UCI-Rocket-Project/rocket2-loadcell2.0-hardware/rocket2-load-cell.step

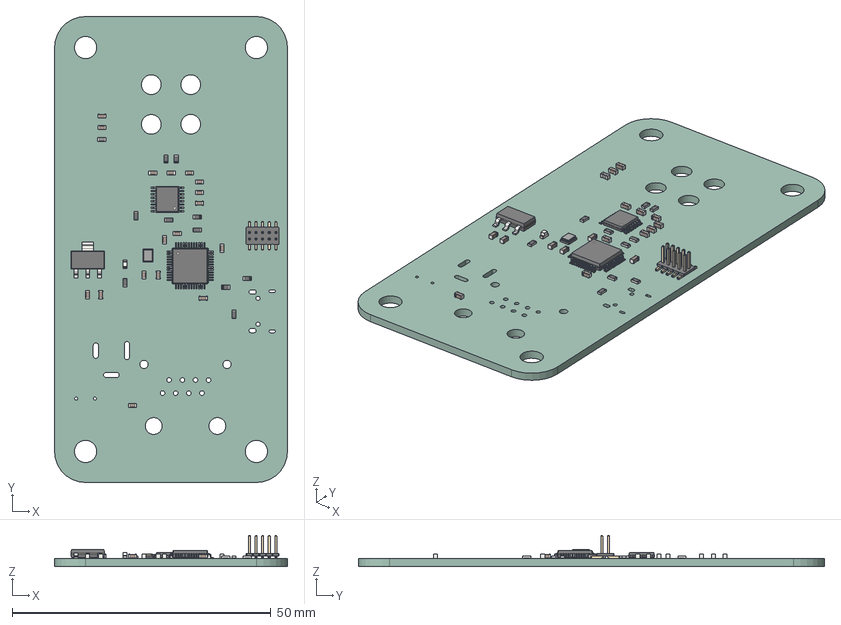
[picture p2: CAD file, 2025-10-12]
rocket2-load-cell.step
45.0 x 90.0 x 6.00 mm
LQFP-48_7x7mm_P0.5mm
C_0603_1608Metric x 17
R_0603_1608Metric x 10
LED_0603_1608Metric
L_0603_1608Metric
TSSOP-16_4.4x5mm_P0.65mm
Crystal_SMD_2520-4Pin_2.5x2.0mm
SOT-223
PinHeader_2x05_P1.27mm_Vertical_SMD
rocket2-load-cell_PCB
