UCI-Rocket-Project/rocket2-loadcell2.0-hardware/rocket2-load-cell.kicad_pcb

## KiCad design rocket2-load-cell.kicad_pcb (2025-11-19)

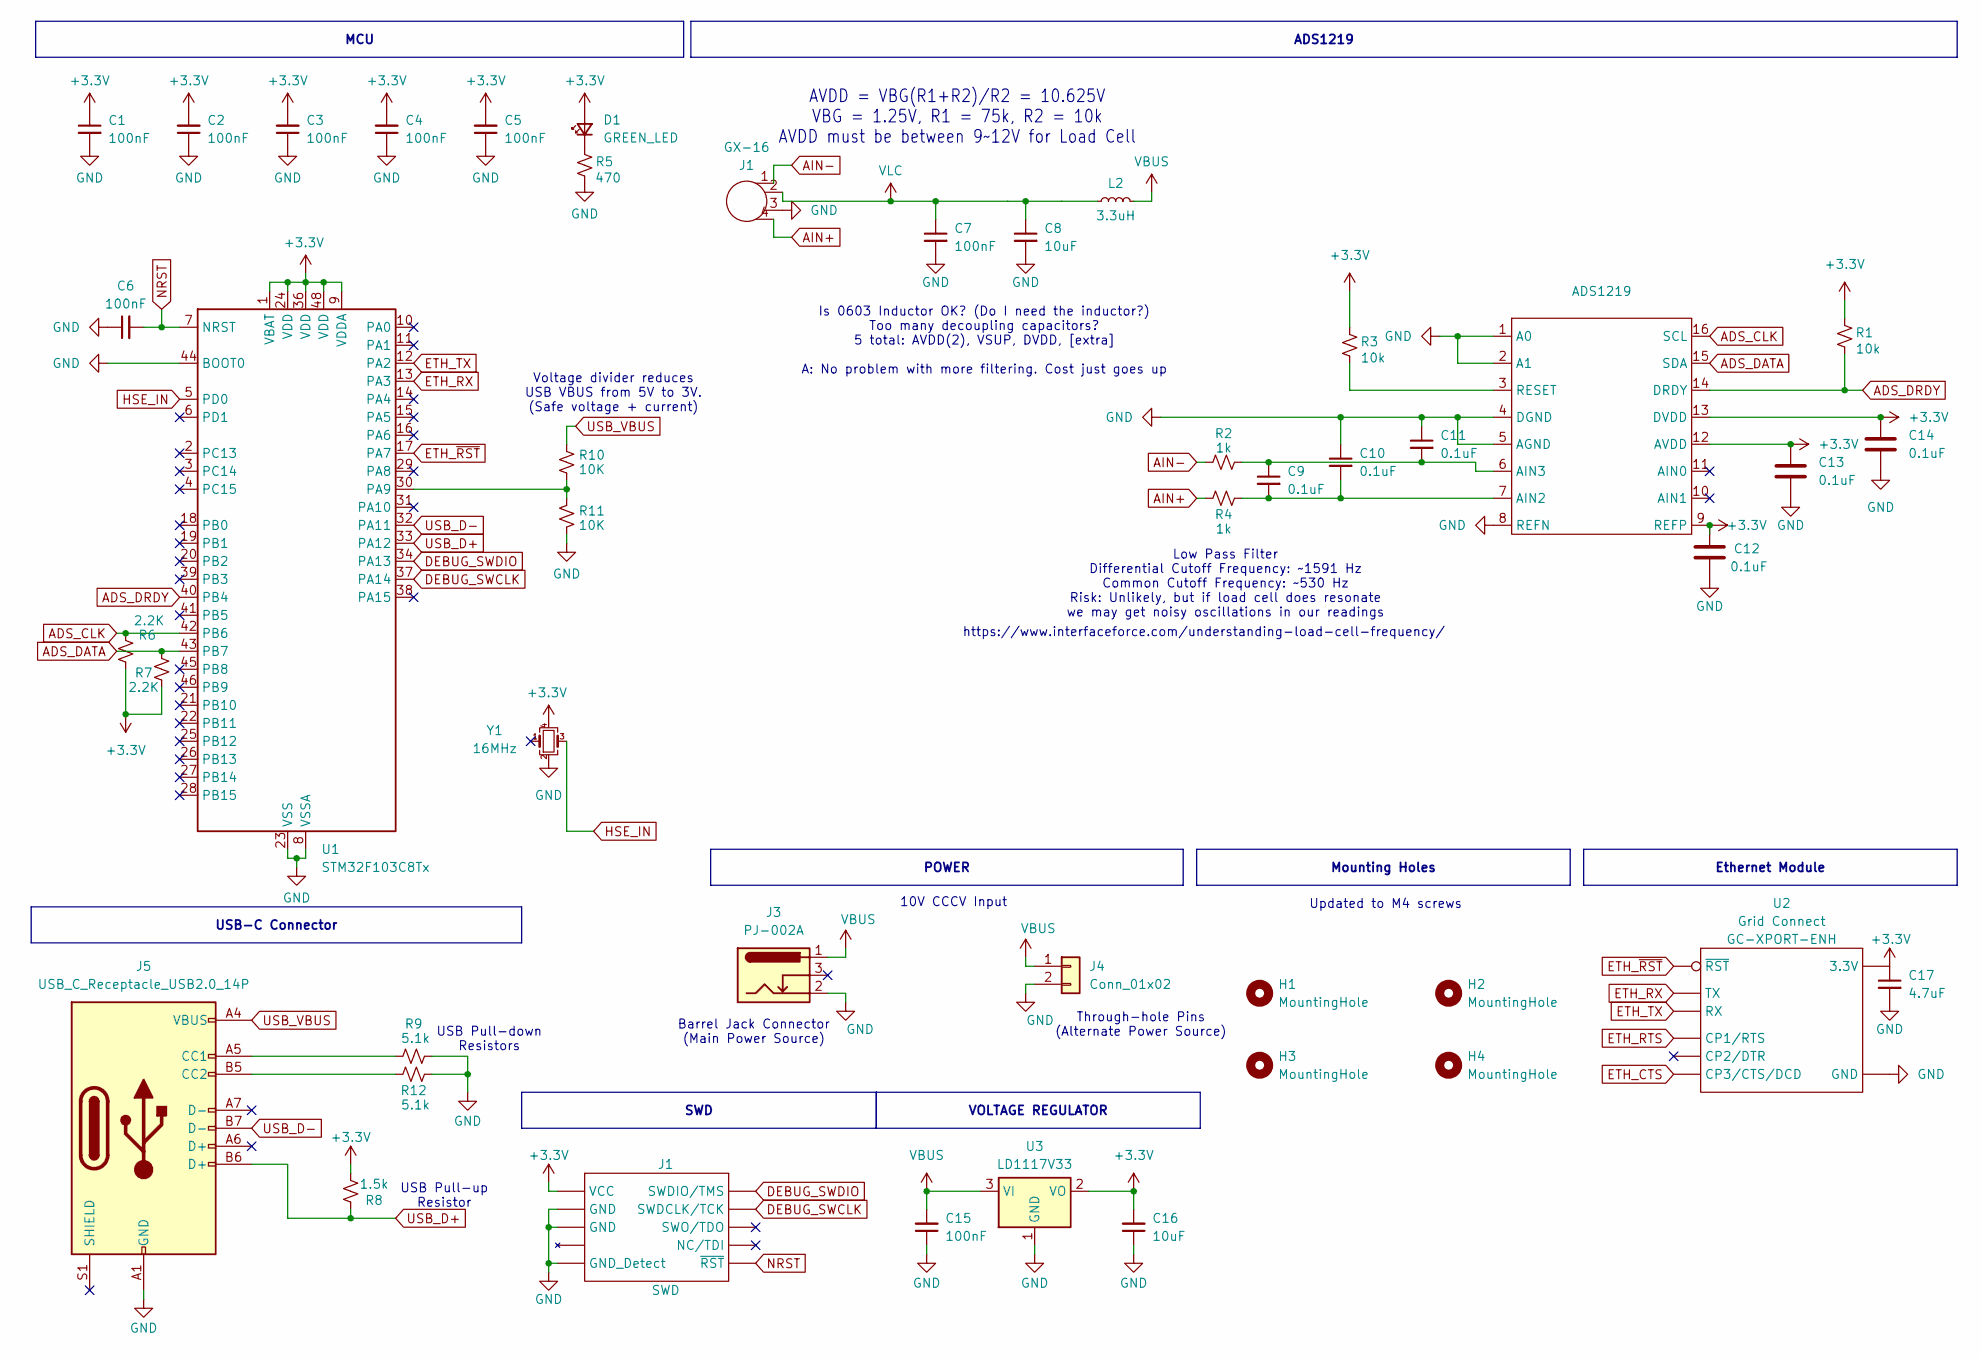
[picture p3: schematic rocket2-load-cell.kicad_sch]

Parts:
ADS1219: TSSOP-16_4.4x5mm_P0.65mm
C1, C2, C3, C4, C5, C6, C7, C15: 100nF; C_0603_1608Metric
C8, C16: 10uF; C_0603_1608Metric
C9, C10, C11, C14: 0.1uF; C_0603_1608Metric
C12, C13: 0.1uF; C_0603_1608Metric_Pad1.08x0.95mm_HandSolder
C17: 4.7uF; C_0603_1608Metric; Part # Generic 4.7uF 6.3V X7R 0603 MLCC
D1: GREEN_LED; LED_0603_1608Metric
GX-16: J1; GX16-4
H1, H2, H3, H4: MountingHole; MountingHole_4.3mm_M4_ISO7380_Pad
J1: SWD; PinHeader_2x05_P1.27mm_Vertical_SMD; Part # Generic 2x05 P1.27mm Vertical Pin Heade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
J3: PJ-002A; CUI_PJ-202A
J4: Conn_01x02
J5: USB_C_Receptacle_USB2.0_14P; USB_C_Receptacle_GCT_USB4110
L2: 3.3uH; L_0603_1608Metric
R1, R3: 10k; R_0603_1608Metric
R2, R4: 1k; R_0603_1608Metric
R5: 470; R_0603_1608Metric
R6, R7: 2.2K; R_0603_1608Metric
R8: 1.5k; R_0603_1608Metric
R9, R12: 5.1k; R_0603_1608Metric
R10, R11: 10K; R_0603_1608Metric
U1: STM32F103C8Tx; LQFP-48_7x7mm_P0.5mm
U2: GC-XPORT; Part # GC-XPORT-ENH
U3: LD1117V33; SOT-223-3_TabPin2
Y1: 16MHz; Crystal_SMD_2520-4Pin_2.5x2.0mm; Part # ECS-1633-160-BN-TR

Connections:
+3.3V: ADS1219.9 (REFP), ADS1219.12 (AVDD), ADS1219.13 (DVDD), C1.1, C2.2, C3.2, C4.2, C5.2, C12.1, C13.1, C14.1, C16.2, C17.1, D1.2 (A), J1.1 (VCC), R1.2, R3.2, R6.2, R7.1, R8.1, U1.1 (VBAT), U1.9 (VDDA), U1.24 (VDD), U1.36 (VDD), U1.48 (VDD), U2.2 (3.3V), U3.2 (VO), Y1.4
ADS_CLK: ADS1219.16 (SCL), R6.1, U1.42 (PB6)
ADS_DATA: ADS1219.15 (SDA), R7.2, U1.43 (PB7)
ADS_DRDY: ADS1219.14 (DRDY), R1.1, U1.40 (PB4)
AIN+: GX-16.4, R4.1
AIN-: GX-16.1, R2.1
DEBUG_SWCLK: J1.4 (SWDCLK/TCK), U1.37 (PA14)
DEBUG_SWDIO: J1.2 (SWDIO/TMS), U1.34 (PA13)
ETH_CTS: U2.8 (CP3/CTS/DCD)
ETH_RTS: U2.6 (CP1/RTS)
ETH_RX: U1.13 (PA3), U2.4 (TX)
ETH_TX: U1.12 (PA2), U2.5 (RX)
ETH_~RST: U1.17 (PA7), U2.3 (~RST)
GND: ADS1219.1 (A0), ADS1219.2 (A1), ADS1219.4 (DGND), ADS1219.5 (AGND), ADS1219.8 (REFN), C1.2, C2.1, C3.1, C4.1, C5.1, C6.1, C7.2, C8.2, C10.1, C11.1, C12.2, C13.2, C14.2, C15.1, C16.1, C17.2, GX-16.3, J1.3 (GND), J1.5 (GND), J1.9 (GND_Detect), J3.2, J4.2, J5.A1 (GND), J5.A12 (GND), J5.B1 (GND), J5.B12 (GND), R5.1, R9.2, R11.1, R12.2, U1.8 (VSSA), U1.23 (VSS), U1.35 (VSS), U1.44 (BOOT0), U1.47 (VSS), U2.1 (GND), U3.1 (GND), Y1.2
HSE_IN: U1.5 (PD0), Y1.3
NRST: C6.2, J1.10 (~RST), U1.7 (NRST)
unnamed: ADS1219.7 (AIN2), C9.2, C10.2, R4.2
unnamed: ADS1219.6 (AIN3), C9.1, C11.2, R2.2
unnamed: ADS1219.3 (RESET), R3.1
unnamed: D1.1 (K), R5.2
unnamed: J5.A5 (CC1), R9.1
unnamed: J5.B5 (CC2), R12.1
unnamed: R10.1, R11.2, U1.30 (PA9)
USB_D+: J5.A6 (D+), J5.B6 (D+), R8.2, U1.33 (PA12)
USB_D-: J5.A7 (D-), J5.B7 (D-), U1.32 (PA11)
USB_VBUS: J5.A4 (VBUS), J5.A9 (VBUS), J5.B4 (VBUS), J5.B9 (VBUS), R10.2
VBUS: C15.2, J3.1, J4.1, L2.2, U3.3 (VI)
VLC: C7.1, C8.1, GX-16.2, L2.1

Notes on the sheet:
Voltage divider reduces USB VBUS from 5V to 3V. (Safe voltage + current)
Updated to M4 screws
AVDD = VBG(R1+R2)/R2 = 10.625V VBG = 1.25V, R1 = 75k, R2 = 10k AVDD must be between 9~12V for Load Cell
Low Pass Filter Differential Cutoff Frequency: ~1591 Hz Common Cutoff Frequency: ~530 Hz Risk: Unlikely, but if load cell does resonate we may get noisy oscillations in our readings
USB Pull-down Resistors
Through-hole Pins (Alternate Power Source)
USB Pull-up Resistor
Barrel Jack Connector (Main Power Source)
https://www.interfaceforce.com/understanding-load-cell-frequency/
10V CCCV Input
Is 0603 Inductor OK? (Do I need the inductor?) Too many decoupling capacitors? 5 total: AVDD(2), VSUP, DVDD, [extra] A: No problem with more filtering. Cost just goes up
USB-C Connector
POWER
VOLTAGE REGULATOR
Mounting Holes
SWD
Ethernet Module
ADS1219
MCU

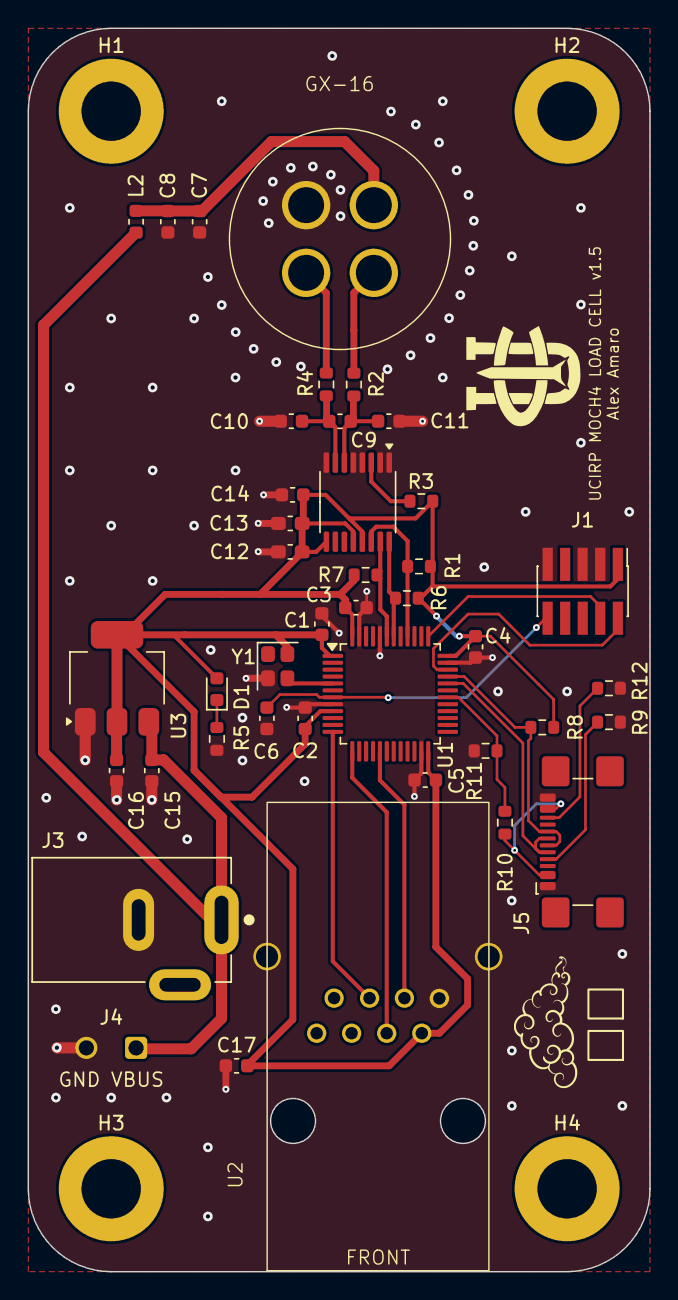
[picture p4: board rocket2-load-cell.kicad_pcb from above]

Board: 2 copper layers, 45.0 x 90.0 mm, 45 parts (0 on the bottom side), 26 nets.
