UCI-Rocket-Project/rocket2-loadcell2.0-hardware/(commit log)

2025-08-18 1.0 Hardware
    All the hardware from v1.0
    [rocket2-load-cell.kicad_pcb, rocket2-load-cell.kicad_sch]
2025-08-30 Minor Schematic Fixes
    >> TX and RX lines now connected to their respective opposites (e.g. TX -> RX)
    >> Changed connector to new standard based on the new load cell
    >> Added datasheets to all schematic symbols
    [rocket2-load-cell.kicad_sch]
2025-09-09 Added USB-B and Filtering
    Replaced memory w/ USB-B connector and strengthened passive RC filtering for differential analog inputs to ADC.
    [rocket2-load-cell.kicad_sch]
2025-09-19 PCB Updates + Schematic Adjustments
    Layout, signal lines, and basis for power routing.
    Added a voltage divider to the USB_VBUS pin to protect GPIO.
    [rocket2-load-cell.kicad_pcb, rocket2-load-cell.kicad_sch]
2025-09-19 Adjustments to Decaps
    More direct GND access
    [rocket2-load-cell.kicad_pcb]
2025-09-20 Power Routing Updates
    W.I.P.
    [rocket2-load-cell.kicad_pcb]
2025-09-23 W.I.P. PCB adjustments
    Reducing e-footprint and signal line length to ADC - also corrected some previous issues with signal + power routing
    [rocket2-load-cell.kicad_pcb]
2025-09-24 complete power + signal routing
    fixed bends, shortened length from MCU -> ADC -> Load Cell
    [rocket2-load-cell.kicad_pcb, rocket2-load-cell.kicad_sch]
2025-09-24 Barrel Jack, New Regulator, and Full Routing
    [rocket2-load-cell.kicad_pcb, rocket2-load-cell.kicad_sch]
2025-09-24 Library updates
    New footprints for barrel jack and regulator
2025-09-25 Updated based on DRC
    Filled zones filled
    [rocket2-load-cell.kicad_pcb, rocket2-load-cell.kicad_sch]
2025-09-28 Added Through-hole Backup Power
    Redundancy for the barrel jack
    [rocket2-load-cell.kicad_pcb, rocket2-load-cell.kicad_sch]
2025-09-30 Final Updates
    Adjusted GX16, reduced E-footprint
    [rocket2-load-cell.kicad_pcb, rocket2-load-cell.kicad_sch]
2025-10-12 Layout adjustments
    Layout revisions based on CDR feedback
    [rocket2-load-cell.kicad_pcb, rocket2-load-cell.kicad_sch, rocket2-load-cell.step]
2025-10-12 Updated GX-16 Footprint based on UCIRP Library
2025-10-14 Final Revisions pt. 2
    Final PCB layout revisions (and a few schematic changes) from Robert (Added USB-C, removed excess vias, etc.)
    [rocket2-load-cell.kicad_pcb, rocket2-load-cell.kicad_sch]
2025-10-14 Final Fix: ADC Layout
    Corrected ADC Layout (Schematic was accidentally mirrored)
    [rocket2-load-cell.kicad_pcb, rocket2-load-cell.kicad_sch]
2025-10-15 Final Adjustment: SWD Power
    Hooked up power after adjusting layout
    [rocket2-load-cell.kicad_pcb]
2025-10-15 Added BOM File
    :]
    [BoM.csv]
2025-11-17 LC v1.5 Fixes (Pt. 1)
    Fixes shorts, pin configurations, among other vital details
    [rocket2-load-cell.kicad_pcb, rocket2-load-cell.kicad_sch]
2025-11-18 LC v1.5 Fixes (Pt. 2)
    Corrected GX-16 footprint, removed vias from ADC, adjusted decap power line routing, and matched length more for ADS_CLK and ADS_DATA
    [rocket2-load-cell.kicad_pcb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]
2025-11-18 LC v1.5 Fixes (Pt. 3)
    Adjusted 10V power line path and filtering on 10V power line near GX connector
    [rocket2-load-cell.kicad_pcb]
2025-11-19 LC v1.5 (Pt. 4)
    Final routing changes
    [rocket2-load-cell.kicad_pcb]
2025-11-19 LC v1.5 Final Fix
    Last Routing Patch for Whole Board
    [rocket2-load-cell.kicad_pcb]
